cjsaiz89/GSM-FTP-transceiver/12V charger r2.pdf

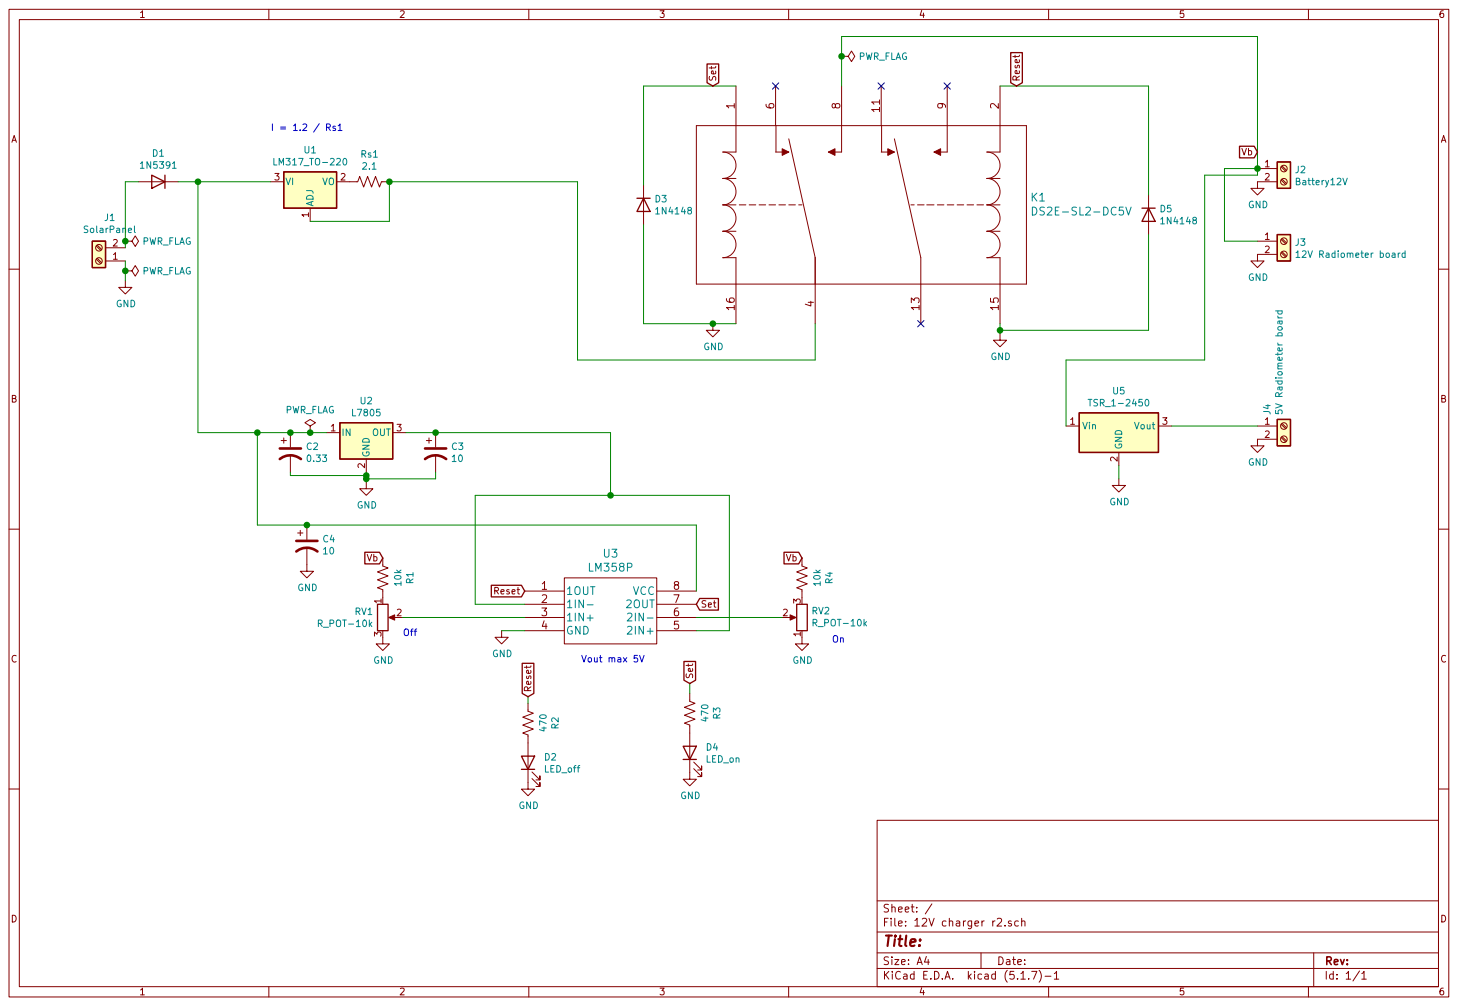
[picture p1: page 1]

File: 12V charger r2.sch Sheet: / D2
