cjsaiz89/GSM-FTP-transceiver/Radiometer amps r2.pdf

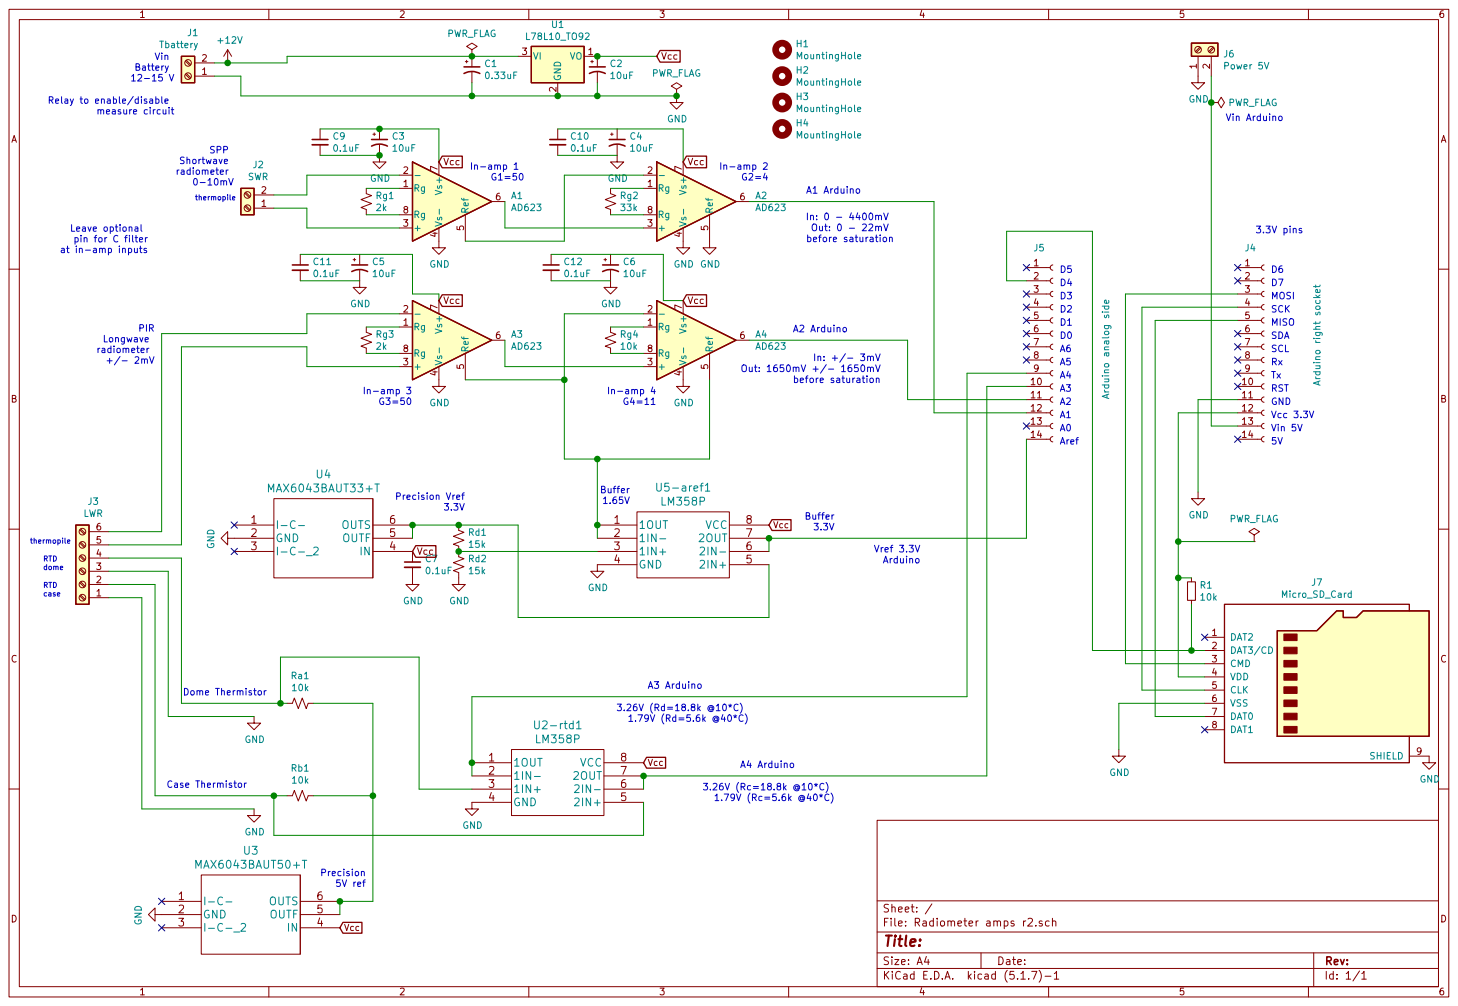
[picture p2: page 1]

Relay to enable/disable measure circuit

In-amp 1 G1=50 SPP Shortwave radiometer 0-10mV

In: 0 - 4400mV Out: 0 - 22mV before saturation

Leave optional
pin for C filter
at in-amp inputs

File: Radiometer amps r2.sch Sheet: /
Id: 1/1 Title:
